TsanaPhysics/iSoil-pH-xAI/hardware/pinout_diagram.md

# แผนผังการต่อสายและข้อมูลขาเชื่อมต่อ (Hardware Pinout Diagram)

## 1. ผังการต่อสายระหว่างโมดูล pH-4502C กับบอร์ด INEX NX-WIO Terminal

```
+---------------------------------------+         +-----------------------------------------+
|     โมดูลวัดค่า pH (pH-4502C)         |         |      บอร์ดทดลอง INEX NX-WIO Terminal    |
|                                       |         |                                         |
|  [ V+ / VCC ] (ไฟเลี้ยงโมดูล 5.0V)   | ------> |  [ +Vs (max 5V) ] (พินจ่ายไฟเลี้ยง 5V)   |
|  [ G  / GND ] (กราวด์ร่วม)            | ------> |  [ GND ]          (พินกราวด์ร่วม)        |
|  [ Po / A-Out ] (สัญญาณอนาล็อก pH)     | ------> |  [ ช่องสกรีน 27 ] (ขา A0 ของ Wio)       |
|  [ Do / D-Out ] (สัญญาณดิจิทัลตัดเกณฑ์)| ------> |  (ไม่ต้องต่อใช้งาน)                     |
|  [ To / Temp  ] (สัญญาณอุณหภูมิบอร์ด)  | ------> |  (ไม่ต้องต่อใช้งาน)                     |
|                                       |         |                                         |
|  [ ขั้วต่อ BNC ]                      | ======> |  เสียบเข้ากับสายโพรบแก้ววัด pH          |
+---------------------------------------+         +-----------------------------------------+
```

---

## 2. แผนผังขา 40-Pin Header ของ Wio Terminal (เข้ากันได้กับ Raspberry Pi)

```
                  [ ด้านหลัง Wio Terminal ]
                    ---------------------
       +3.3V Power  [ 1]  [ 2]  +5.0V Power  <--- [ต่อไฟเลี้ยง V+ ของ pH-4502C ที่นี่]
     BCM 2 (SDA/I2C) [ 3]  [ 4]  +5.0V Power
     BCM 3 (SCL/I2C) [ 5]  [ 6]  GND         <--- [ต่อกราวด์ G ของ pH-4502C ที่นี่]
             BCM 4  [ 7]  [ 8]  BCM 14 (TXD)
               GND  [ 9]  [10]  BCM 15 (RXD)
            BCM 17  [11]  [12]  BCM 18 (PWM)
[A0] <---   BCM 27  [13]  [14]  GND
(ต่อ Po)    BCM 22  [15]  [16]  BCM 23
             +3.3V  [17]  [18]  BCM 24
     BCM 10 (MOSI)  [19]  [20]  GND
      BCM 9 (MISO)  [21]  [22]  BCM 25
     BCM 11 (SCLK)  [23]  [24]  BCM 8 (CE0)
               GND  [25]  [26]  BCM 7 (CE1)
            ID_SD   [27]  [28]  ID_SC
             BCM 5  [29]  [30]  GND
             BCM 6  [31]  [32]  BCM 12 (PWM)
            BCM 13  [33]  [34]  GND
    BCM 19 (MISO2)  [35]  [36]  BCM 16
            BCM 26  [37]  [38]  BCM 20 (MOSI2)
               GND  [39]  [40]  BCM 21 (SCLK2)
                    ---------------------
```

---

## 3. ข้อควรระวังระดับแรงดันไฟฟ้า (Voltage Matching)
* **ไฟเลี้ยงโมดูล:** 5.0V DC จากพอร์ต USB ของบอร์ด
* **อินพุต ADC ของ MCU:** ชิป ATSAMD51 ทนแรงดันไม่เกิน **3.30V**
* **การปรับจูนความปลอดภัย:** ปรับทริมพอตตัวล่าง (Offset Trimmer) ของโมดูล pH-4502C ให้แรงดันขา `Po` อยู่ที่ **1.650V** เมื่อจำลอง pH 7.00
