TsanaPhysics/iSoil-pH-xAI/docs/AI_SOIL_PH_METER_MANUAL.md

# คู่มือฉบับสมบูรณ์สำหรับผู้เริ่มต้น
# ระบบ iSoil pH xAI: เครื่องวัดความเป็นกรด-ด่างของดินภาคสนามความแม่นยำสูงด้วยปัญญาประดิษฐ์ฝังตัว
## (Beginner's Master Manual: Building and Operating the iSoil pH xAI Field-Portable Soil pH Meter)

---

**โครงการวิจัย** การพัฒนาต้นแบบเครื่องวัดความเป็นกรด-ด่างของดินแบบพกพาภาคสนามความแม่นยำสูงด้วยการชดเชยความคลาดเคลื่อนโดยปัญญาประดิษฐ์  
**แหล่งทุนสนับสนุน** กองทุนวิจัย มหาวิทยาลัยราชภัฏรำไพพรรณี ประจำปีงบประมาณ พ.ศ. 2569  
**คณะผู้วิจัย**  
* อาจารย์ธนพัฒน์ ถิระวุฒิ (หัวหน้าโครงการวิจัย)  
* ผู้ช่วยศาสตราจารย์ ดร.ชีวะ ทัศนา (ผู้ร่วมวิจัยและผู้เชี่ยวชาญด้านสมองกลฝังตัวและปัญญาประดิษฐ์)  
* ผู้ช่วยศาสตราจารย์ ดร.นันทพร มูลรังษี (ผู้ร่วมวิจัยและผู้เชี่ยวชาญด้านเคมีวิเคราะห์)  
**สังกัด** คณะวิทยาศาสตร์และเทคโนโลยี มหาวิทยาลัยราชภัฏรำไพพรรณี  

---

## สารบัญ

1. [บทนำและความสำคัญเชิงเกษตรฟิสิกส์](#1-บทนำและความสำคัญเชิงเกษตรฟิสิกส์)
2. [รากฐานทางทฤษฎีและฟิสิกส์เซนเซอร์](#2-รากฐานทางทฤษฎีและฟิสิกส์เซนเซอร์)
3. [ข้อมูลจำเพาะทางวิศวกรรมของฮาร์ดแวร์](#3-ข้อมูลจำเพาะทางวิศวกรรมของฮาร์ดแวร์)
4. [ผังวงจรและการเชื่อมต่อระบบ](#4-ผังวงจรและการเชื่อมต่อระบบ)
5. [สถาปัตยกรรมปัญญาประดิษฐ์ชดเชยความคลาดเคลื่อน (TinyML ANN 2-4-1)](#5-สถาปัตยกรรมปัญญาประดิษฐ์ชดเชยความคลาดเคลื่อน)
6. [คู่มือการติดตั้งและคำอธิบายซอร์สโค้ดเฟิร์มแวร์ Wio Terminal](#6-คู่มือการติดตั้งและคำอธิบายซอร์สโค้ด)
7. [ระบบฐานข้อมูลและแดชบอร์ดเว็บแอปพลิเคชัน](#7-ระบบฐานข้อมูลและแดชบอร์ดเว็บแอปพลิเคชัน)
8. [ขั้นตอนปฏิบัติการสอบเทียบและการเก็บตัวอย่างดิน](#8-ขั้นตอนปฏิบัติการสอบเทียบและการเก็บตัวอย่างดิน)
9. [คู่มือการใช้งานภาคสนามและการแปลผล](#9-คู่มือการใช้งานภาคสนามและการแปลผล)
10. [การแก้ไขปัญหาและการบำรุงรักษา](#10-การแก้ไขปัญหาและการบำรุงรักษา)
11. [ประวัติคณะผู้วิจัย](#11-ประวัติคณะผู้วิจัย)

---

## 1. บทนำและความสำคัญเชิงเกษตรฟิสิกส์

ความเป็นกรด-ด่างของดิน (Soil pH) คือตัวแปรเคมีฟิสิกส์ที่มีความสำคัญเป็นลำดับแรกในการประเมินความอุดมสมบูรณ์ของดินทางการเกษตร โดยเฉพาะในพื้นที่เพาะปลูกพืชเศรษฐกิจมูลค่าสูงของภาคตะวันออก เช่น ทุเรียน (*Durio zibethinus* Murr.) ในจังหวัดจันทบุรีและจังหวัดตราด 

เมื่อดินมีสภาพเป็นกรดรุนแรง (pH ต่ำกว่า 5.0) ไอออนของอะลูมิเนียมและแมงกานีสจะละลายออกมาจนถึงระดับที่เป็นพิษต่อระบบรากพืช ขัดขวางการดูดซึมธาตุอาหารหลัก ได้แก่ ไนโตรเจน ฟอสฟอรัส และโพแทสเซียม ทำให้ต้นทุเรียนแคระแกร็นและอ่อนแอต่อโรครากเน่าโคนเน่า ในทางวิชาการ ระดับความเป็นกรด-ด่างที่เหมาะสมที่สุดสำหรับการเจริญเติบโตของทุเรียนอยู่ในช่วง pH 5.5 ถึง 6.5

เกษตรกรส่วนใหญ่ยังประสบปัญหาในการตรวจวัดดินภาคสนาม เนื่องจากเครื่องมือวัดราคาประหยัดที่จำหน่ายทั่วไปมีความคลาดเคลื่อนสูงอันเนื่องมาจากอุณหภูมิที่ผันผวนและความไม่เป็นเชิงเส้นของเยื่อแก้ว ขณะที่เครื่องมือมาตรฐานในห้องปฏิบัติการมีราคาสูงและต้องใช้เวลาในการส่งตรวจ โครงการวิจัยนี้จึงได้นำเทคโนโลยีสมองกลฝังตัวประสิทธิภาพสูงร่วมกับโครงข่ายประสาทเทียม (Artificial Neural Network หรือ ANN) มาสร้างเป็นเครื่องมือวัดภาคสนามที่รวมความแม่นยำระดับห้องปฏิบัติการเข้ากับความสะดวกในการพกพา

---

## 2. รากฐานทางทฤษฎีและฟิสิกส์เซนเซอร์

### 2.1 สมการเนิร์นสต์และการตอบสนองเชิงเคมีไฟฟ้า

การวัดค่าความเป็นกรด-ด่างด้วยวิธีโพเทนชิออเมตริก (Potentiometric Method) อาศัยการวัดความต่างศักย์ไฟฟ้าระหว่างขั้วไฟฟ้าบ่งชี้ (Glass Indicator Electrode) และขั้วไฟฟ้าอ้างอิง (Reference Electrode) ตามสมการเนิร์นสต์ (Nernst Equation) ในรูปแบบอุดมคติดังนี้

$$E = E^0 - \frac{2.303 R T}{n F} \cdot \text{pH}$$

เมื่อกำหนดให้
* $E$ คือ ศักย์ไฟฟ้าที่วัดได้จากเซลล์เคมีไฟฟ้า (โวลต์)
* $E^0$ คือ ศักย์ไฟฟ้ามาตรฐานของเซลล์ (โวลต์)
* $R$ คือ ค่าคงที่สากลของแก๊ส มีค่าเท่ากับ $8.314 \text{ J}\cdot\text{mol}^{-1}\cdot\text{K}^{-1}$
* $T$ คือ อุณหภูมิสัมบูรณ์ (เคลวิน) โดย $T = \text{อุณหภูมิในหน่วยองศาเซลเซียส} + 273.15$
* $n$ คือ จำนวนอิเล็กตรอนที่เกี่ยวข้อง ในกรณีของไฮโดรเจนไอออนมีค่าเท่ากับ 1
* $F$ คือ ค่าคงที่ฟาราเดย์ มีค่าเท่ากับ $96,485 \text{ C}\cdot\text{mol}^{-1}$

พจน์ความชันของการตอบสนองเรียกว่า Nernstian Slope ($S$) ซึ่งขึ้นตรงต่ออุณหภูมิสัมบูรณ์ $T$

$$S(T) = \frac{2.303 R T}{F}$$

ที่อุณหภูมิมาตรฐาน $25^\circ\text{C}$ (298.15 K) ค่าความชันตามทฤษฎีจะมีค่าเท่ากับ $59.16 \text{ mV}$ ต่อหนึ่งหน่วย pH แต่เมื่อนำเครื่องมือไปใช้งานภาคสนามในพื้นที่แปลงเกษตรที่มีอุณหภูมิตั้งแต่ $20^\circ\text{C}$ ถึง $45^\circ\text{C}$ ค่าความชันจะเบี่ยงเบนไประหว่าง $58.17 \text{ mV/pH}$ ถึง $63.13 \text{ mV/pH}$ ซึ่งหากไม่มีการชดเชยจะทำให้การอ่านค่าเกิดความคลาดเคลื่อนสะสมอย่างรุนแรง

### 2.2 กลไกความคลาดเคลื่อนที่ไม่เป็นเชิงเส้น (Non-linearity Error)

นอกจากผลกระทบของอุณหภูมิตามสมการเนิร์นสต์แล้ว เซนเซอร์หัววัดแก้วในทางปฏิบัติยังมีพฤติกรรมที่ไม่เป็นเชิงเส้นอันเนื่องมาจาก
1. ศักย์อสมมาตร (Asymmetry Potential) บนเยื่อแก้วบางทั้งสองด้าน
2. การเสื่อมสภาพและการเกาะติดของสารอินทรีย์ในอนุภาคดิน
3. อิทธิพลของแรงดันตกคร่อมรอยต่อของเหลว (Liquid Junction Potential)

### 2.3 ความหมายทางฟิสิกส์ของค่าเนิร์นสต์ (Physical Meaning of Nernst Value)
สมการเนิร์นสต์ (Nernst Equation) คิดค้นโดย Walther Nernst นักเคมีฟิสิกส์ชาวเยอรมัน (รางวัลโนเบลสาขาเคมี ค.ศ. 1920) เป็นสมการพื้นฐานทางอุณหพลศาสตร์เคมีไฟฟ้าที่อธิบายความสัมพันธ์ระหว่าง ศักย์ไฟฟ้าของเซลล์ (Cell Potential, $E$) กับ ความเข้มข้นของไฮโดรเจนไอออนในสารละลาย โดยพจน์ความชันเนิร์นสเตียน $S(T) = \frac{2.303 R T}{F}$ แสดงว่าทุกๆ 1 หน่วย pH ศักย์ไฟฟ้าจะเปลี่ยนไป $59.16\text{ mV}$ (ที่ $25^\circ\text{C}$)

ตัวเลขที่แสดงผลหลังข้อความ `NERNST` บนหน้าจอ Wio Terminal คือ ค่า pH เชิงเส้นตามทฤษฎีอุณหพลศาสตร์บริสุทธิ์ของเนิร์นสต์ ซึ่งคำนวณจากสมการ:
$$\text{pH}_{\text{Nernst}} = 7.00 - \frac{V_{\text{meas}} - V_{\text{zero}}}{S(T)}$$
ค่านี้เป็นค่าอ้างอิงก่อนที่อัลกอริทึมปัญญาประดิษฐ์จะทำการชดเชยความคลาดเคลื่อนที่ไม่เป็นเชิงเส้น

### 2.4 การสืบค้นวรรณกรรมและทฤษฎีการวิเคราะห์ pH ของดิน (Literature Review & Soil pH Models)
ในทางปฐพีวิทยาและเคมีดิน ปรากฏการณ์ความคลาดเคลื่อนจากการแขวนลอย (Suspension Effect) ได้รับการบันทึกทางประวัติศาสตร์วิจัยมาอย่างยาวนานตั้งแต่การศึกษาของ Jenny et al. (1950) และ Peech (1965) ซึ่งระบุว่า เมื่อจุ่มหัววัดแก้วลงในสารแขวนลอยดิน อนุภาคคอลลอยด์ของดินเหนียวที่มีประจุลบสูงจะเหนี่ยวนำให้เกิด **ศักย์ไฟฟ้าดอนแนน (Donnan Potential: $\Delta E_{\text{Donnan}}$)** ขึ้นระหว่างชั้นอนุภาคดินกับสารละลายด้านบน ส่งผลให้การแพร่ของไอออน $\text{K}^+$ และ $\text{Cl}^-$ จากรอยต่อของเหลวของขั้วอ้างอิงเกิดความไม่สมดุล เกิดแรงดันตกคร่อมเทียมรบกวนทำให้ค่า pH ที่คำนวณจากสมการเนิร์นสต์เส้นตรงคลาดเคลื่อนไปจากความเป็นจริง $0.3 - 1.2\text{ pH}$

ตามระเบียบวิธีวิจัยมาตรฐานในห้องปฏิบัติการ (ISRIC \& USDA-NRCS Standard Protocols) นักวิทยาศาสตร์ดินจำเป็นต้องใช้สารละลายเกลือ $0.01\text{ M } \text{CaCl}_2$ หรือ $1\text{ M } \text{KCl}$ แทนการใช้น้ำกลั่นบริสุทธิ์ในการสกัดตัวอย่างดิน เพื่อเพิ่มความแรงไอออนิก (Ionic Strength) ของสารละลายและกดทับศักย์ไฟฟ้าจุดต่อของเหลว อย่างไรก็ตาม ในการตรวจวัดแบบพกพาภาคสนาม (In-situ Rapid Field Sensing) เกษตรกรและนักวิจัยภาคสนามไม่สามารถเตรียมสารเคมีออกไปภาคสนามได้โดยสะดวก

ด้วยเหตุนี้ โครงการวิจัย **iSoil pH xAI** จึงได้นำแนวคิด **การชดเชยความคลาดเคลื่อนด้วยปัญญาประดิษฐ์ฝังตัว (Edge TinyML Non-linear Metrology)** เข้ามาประยุกต์ใช้ โดยพัฒนาโครงข่ายประสาทเทียม Multi-Layer Perceptron (2-4-1 MLP) ทำหน้าที่เป็นตัวประมาณฟังก์ชันสากล (Universal Non-linear Function Approximator):
$$\text{pH}_{\text{AI}} = f_{\text{ANN}}\left( V_{\text{cell}}, T_{\text{meas}}, \mathbf{W}_{\text{soil}} \right)$$
โดยโมเดลจะเรียนรู้เมทริกซ์การชดเชยที่ไม่เป็นเชิงเส้นระหว่างแรงดันไฟฟ้า ($V_{\text{cell}}$) อุณหภูมิดินจริง ($T_{\text{meas}}$) และประเภทเนื้อดิน ($\mathbf{W}_{\text{soil}}$) ทำให้สามารถหักล้างผลกระทบของศักย์ไฟฟ้าดอนแนนและอุณหภูมิได้อย่างแม่นยำ โดยไม่ต้องพึ่งพาสารเคมี $\text{CaCl}_2$ ในแปลงเกษตรจริง

---

## 3. ข้อมูลจำเพาะทางวิศวกรรมของฮาร์ดแวร์

| องค์ประกอบ | ข้อมูลจำเพาะทางเทคนิค | รายละเอียดเชิงวิศวกรรม |
| :--- | :--- | :--- |
| **ไมโครคอนโทรลเลอร์** | Seeed Studio Wio Terminal (D51R) | Microchip ATSAMD51P19A (ARM Cortex-M4F @ 120MHz, 512KB Flash, 192KB RAM) มี FPU ในตัว |
| **หน้าจอแสดงผล** | 2.4 นิ้ว TFT LCD (320 × 240 พิกเซล) | ควบคุมด้วยชิป ILI9341V ผ่านบัส SPI ความเร็วสูง รองรับการแสดงผลกราฟิกและกราฟเรียลไทม์ |
| **หน่วยประมวลผลไร้สาย** | Realtek RTL8720DN | รองรับ Dual-Band Wi-Fi (2.4GHz และ 5GHz) พร้อม Bluetooth BLE 5.0 |
| **การแปลงสัญญาณอนาล็อก** | 12-bit Successive Approximation ADC | ค่าความละเอียด 4096 ระดับ (0 ถึง 4095) บนแรงดันอ้างอิง 3.30V |
| **หน่วยความจำสำรอง** | MicroSD Card Slot ในตัว | รองรับการ์ด FAT16 และ FAT32 สูงสุด 32GB ทำงานผ่านบัส SPI ความเร็วสูง |
| **ปุ่มควบคุม** | 5-way Tactile Switch และ 3 User Buttons | ปุ่มจอยสติ๊ก 5 ทิศทางสำหรับเลือกโมเดล AI และ 3 ปุ่มกดโหมดปฏิบัติการ (Key A/B/C) |
| **โมดูลวัดค่า pH** | โมเดลยอดนิยม pH-4502C | มีชิป Dual Op-Amp (LM358) พร้อมวงจรปรับ Offset สัญญาณ และจุดเชื่อมต่อหัววัดแบบ BNC |
| **หัววัดอิเล็กโทรด** | Glass Combination Electrode Probe | โพรบแก้ววัดศักย์ไฟฟ้าเคมี บรรจุสารละลายอ้างอิง 3M KCl มีปลอกยางกันกระแทก |
| **บอร์ดขยายการทดลอง** | INEX NX-WIO Terminal Board | วงจรควบคุมไฟเลี้ยง วงจรป้องกันกระแสเกิน พอร์ตขยาย 28 พิน และเบรดบอร์ดในตัว |

### 3.1 หัววัด pH แบบ 3-in-1 Combination Probe: สเปก แหล่งจัดซื้อในไทย และวงจรชดเชยอุณหภูมิ (ATC)
เพื่อให้การประมวลผลของโมเดล AI สามารถชดเชยผลกระทบจากอุณหภูมิแบบเรียลไทม์ได้อย่างสมบูรณ์แบบ (Automatic Temperature Compensation: ATC) ระบบ iSoil pH xAI รองรับ **หัววัดชนิดรวม 3 ตัวแปรในก้านเดียว (3-in-1 Combination Probe)** ซึ่งรวมเอา (1) เยื่อแก้ววัดประจุไอออน pH (2) ขั้วอ้างอิง Ag/AgCl และ (3) เซนเซอร์วัดอุณหภูมิชนิดเทอร์มิสเตอร์ NTC 10K หรือ Pt1000 ไว้ภายในโครงสร้างเดียวกัน

#### ข้อแนะนำสำคัญในการเลือกซื้อหัววัดสำหรับตรวจวัดดิน
1. **ปลายหัววัดรูปหอก (Spear Tip / Puncture Type):** แนะนำอย่างยิ่งสำหรับดินสวนทุเรียนและดินกึ่งแข็ง เนื่องจากสามารถปักเจาะทะลุชั้นดินได้โดยไม่แตกหักง่าย แตกต่างจากหัววัดแก้วทรงกลม (Spherical Bulb) ทั่วไปที่เสี่ยงต่อการแตกร้าวจากก้อนหินและเศษกรวด
2. **รอยต่อของเหลวชนิดป้องกันการอุดตัน (Open Junction / Polymer Solid Electrolyte):** สารละลายดินมีอนุภาคแขวนลอยละเอียด หัววัดที่ใช้รอยต่อ Ceramic Frits ทั่วไปจะเกิดการอุดตันอย่างรวดเร็ว ควรเลือกรุ่นที่มีรอยต่อแบบเปิดหรือโพลีเมอร์แข็ง
3. **ขั้วต่อสัญญาณ (Connectors):** สัญญาณ pH ต้องเป็นหัวขั้ว **BNC** มาตรฐาน ส่วนสัญญาณอุณหภูมิจาก NTC 10K มักแยกออกมาเป็นแจ็ค RCA (Cinch) หรือสายเปลือย 2 เส้น

#### แหล่งจัดซื้อหัววัด pH แบบ 3-in-1 ในประเทศไทย
| รุ่นและแบรนด์ | ลักษณะทางกายภาพ | เซนเซอร์อุณหภูมิ | แหล่งจัดจำหน่ายในไทยและราคาประมาณ |
| :--- | :--- | :--- | :--- |
| **DFRobot Gravity (SEN0249)** | ก้านแก้ว Spear Tip ทนทาน ปลายแหลมเจาะดิน | ภายนอก (ใช้ร่วมกับ NTC/DS18B20) | Cybertice, ThaiEasyElec, Gravitech TH (~1,800 - 2,400 บาท) |
| **Mettler Toledo LE427 / InLab Solids Pro** | ก้านแก้ว Spear เจาะดินและอาหาร รอยต่อเปิด | Pt1000 / NTC 30K ในตัว | บริษัท เอ็นพี เคมิคอล, Merit Tech, ตัวแทนแล็บวิจัย (~8,500 - 14,000 บาท) |
| **Ohaus ST320 / ST350 (3-in-1)** | ตัวเรือนพลาสติก Gel BNC + Cinch | NTC 30K / NTC 10K ภายในก้าน | บริษัท นีโอนิคส์ (Neonics), Scma, Lazada Mall (~3,200 - 4,800 บาท) |
| **Apera LabSen 553 / 753** | Spear Glass สำหรับดินและสารแขวนลอยโดยเฉพาะ | NTC 10K ในตัว (BNC + RCA) | Apera Instruments Official, ตัวแทนจำหน่ายเครื่องมือวิทยาศาสตร์ (~4,500 - 6,500 บาท) |
| **Industrial Soil 3-in-1 Spear Probe** | โพรบสแตนเลส/พลาสติกปลายแหลมสำหรับแปลงเกษตร | NTC 10K (3.3V Divider) | Shopee, Lazada, AliExpress (ค้นหาคำว่า "pH Spear BNC NTC 10k") (~950 - 1,600 บาท) |

#### การต่อวงจรเซนเซอร์อุณหภูมิ 3-in-1 (ATC) เข้ากับ Wio Terminal
* **สัญญาณ pH (BNC):** เสียบเข้ากับเต้ารับ BNC ของโมดูล pH-4502C และนำขาแอนะล็อก Po ต่อเข้ากับขา **A0** ของ Wio Terminal
* **สัญญาณอุณหภูมิ (NTC 10K):** ต่อเข้าสู่วงจรแบ่งแรงดัน (Voltage Divider) โดยใช้ตัวต้านทานพูลอัป $10\text{ k}\Omega$ ต่อเข้ากับไฟเลี้ยง 3.3V และส่งแรงดันกึ่งกลางเข้าขา **A1 (TEMP_PIN)** ของ Wio Terminal
* **ระบบตรวจจับอัตโนมัติ (Dual ATC/MTC Engine):** เฟิร์มแวร์จะทำการตรวจสอบแรงดันที่ขา A1 หากพบแรงดันในช่วง 0.2V ถึง 3.1V ระบบจะเปิดโหมด **ATC (Automatic)** และคำนวณอุณหภูมิดินจริงผ่านสมการ Steinhart-Hart ทันที หากไม่ได้ต่อสาย ระบบจะสลับไปใช้โหมด **MTC (Manual $25^\circ\text{C}$)** โดยอัตโนมัติ

---

## 4. ผังวงจรและการเชื่อมต่อระบบ

### 4.1 ตารางการต่อสายระหว่างโมดูล pH-4502C กับบอร์ด INEX NX-WIO

```
 +--------------------+                     +------------------------------+
 |  โมดูล pH-4502C    |                     |  บอร์ด INEX NX-WIO Terminal  |
 |                    |                     |                              |
 |  [ V+ / VCC ] ---->|-------------------->| [ +Vs (max 5V) ]             |
 |  [ G  / GND ] ---->|-------------------->| [ GND ]                      |
 |  [ Po / Analog ] ->|-------------------->| [ ช่องเลข 27 (ขา A0) ]        |
 |  [ Do / Dig ]      |  (ไม่ต้องต่อ)         |                              |
 |  [ To / Temp ]     |  (ไม่ต้องต่อ)         |                              |
 |  [ ขั้ว BNC ] ---->|====================>| หัวโพรบแก้ววัด pH             |
 +--------------------+                     +------------------------------+
```

### 4.2 ระบบการควบคุม 3 โหมดปฏิบัติการ (Key A/B/C)
ระบบควบคุมได้รับการออกแบบให้สลับโหมดการทำงานได้อย่างคล่องตัวผ่านปุ่มกด 3 ปุ่มด้านบนของ Wio Terminal:
* **ปุ่ม C (โหมด 1: สอบเทียบหัววัด CALIBRATION MODE):** ใช้สำหรับสอบเทียบหัววัดด้วยสารละลายบัฟเฟอร์มาตรฐาน 3 จุด (pH 7.00, pH 4.01, pH 10.01) หน้าจอแสดงค่าความชันจริง ($S_{\text{meas}}$) และเปอร์เซ็นต์ประสิทธิภาพของหัววัด (% Efficiency)
* **ปุ่ม B (โหมด 2: เรียนรู้และสร้างโมเดล AI DATA COLLECTION / TRAINING):** ใช้สำหรับเก็บตัวอย่างวิจัยภาคสนามเพื่อสร้าง Dataset ฝึกฝนโมเดล AI หน้าจอจะแสดงชนิดตัวอย่างดิน ศักย์ไฟฟ้า ค่าเนิร์นสต์ และจำนวนตัวอย่างที่บันทึกสะสมลงไฟล์ `/train_dataset.csv`
* **ปุ่ม A (โหมด 3: ใช้งานจริงภาคสนาม FIELD RUN / AI ACTIVE):** โหมดหลักสำหรับการตรวจวัดดินจริง แสดงผลตัวเลข AI pH ขนาดใหญ่พิเศษ พร้อมข้อความวินิจฉัยสุขภาพดินเพื่อการเพาะปลูกทุเรียน ค่าความเชื่อมั่น AI Confidence Score (%) และกราฟเปรียบเทียบสองมิติแบบเรียลไทม์

### 4.3 ระบบสลับโมเดล AI เฉพาะชนิดดิน (5-Way Joystick Model Selector)
ในโหมดใช้งานจริง (Field Run) ผู้ใช้สามารถเลื่อน **ปุ่มจอยสติ๊ก 5 ทิศทางขึ้นหรือลง** เพื่อเปลี่ยนแบบจำลอง AI ให้ตรงกับลักษณะของดินในแปลง:
1. **ANN DURIAN (โมเดลดินสวนทุเรียน):** ปรับแต่งพิเศษสำหรับดินลูกรังและดินร่วนปนทรายภาคตะวันออก (จันทบุรี/ตราด) ที่มีธาตุเหล็กและอะลูมิเนียมสูง แม่นยำเป็นพิเศษในช่วง pH 4.5 ถึง 7.0 ($R^2 = 0.988, \text{RMSE} = 0.052$)
2. **ANN LOAM (โมเดลดินร่วน):** ปรับแต่งสำหรับดินร่วนที่มีอินทรียวัตถุสูง เพื่อชดเชยการแตกตัวของกรดฮิวมิก ($R^2 = 0.984, \text{RMSE} = 0.064$)
3. **ANN CLAY (โมเดลดินเหนียว):** ออกแบบเพื่อชดเชยปรากฏการณ์ดอนแนน (Donnan Potential) และผลการแขวนลอยของอนุภาคดินเหนียว ($R^2 = 0.979, \text{RMSE} = 0.071$)
4. **ANN UNIV (โมเดลมาตรฐานทั่วไป):** โมเดลอเนกประสงค์สำหรับการตรวจวัดสารละลายเคมีและบัฟเฟอร์มาตรฐาน ($R^2 = 0.992, \text{RMSE} = 0.038$)

### 4.4 ข้อพิจารณาเรื่องแรงดันไฟฟ้า (Critical Voltage Level Matching)

1. **ไฟเลี้ยงโมดูลเซนเซอร์:** ต้องต่อเข้ากับช่อง **+Vs (max 5V)** เท่านั้น เนื่องจากวงจรออปแอมป์และแรงดันอ้างอิงภายในบอร์ด pH-4502C ต้องการไฟเลี้ยงอย่างน้อย 5.0V จึงจะทำงานได้เป็นเชิงเส้น
2. **ขีดจำกัดแรงดัน ADC:** ชิป ATSAMD51 บน Wio Terminal ทนแรงดันอินพุตสูงสุดที่ **3.30V**
3. **การตั้งค่าออฟเซ็ตความปลอดภัย:** ต้องปรับทริมพอตตัวล่าง (Offset Trimmer) ของโมดูล pH-4502C ให้จ่ายแรงดันที่สภาวะ pH 7.00 เท่ากับ **1.650V** (กึ่งกลางของช่วง 0 ถึง 3.3V) เพื่อให้สัญญาณช่วง pH 0 ถึง 14 แกว่งอยู่ระหว่าง 0.3V ถึง 3.0V ซึ่งอยู่ในช่วงปลอดภัย 100%

---

## 5. สถาปัตยกรรมปัญญาประดิษฐ์ชดเชยความคลาดเคลื่อน

แบบจำลองปัญญาประดิษฐ์ที่พัฒนาขึ้นเป็นโครงข่ายประสาทเทียมแบบป้อนตรง (Multilayer Perceptron หรือ MLP) ฝังตัวลงในหน่วยความจำของไมโครคอนโทรลเลอร์ (TinyML Deployment)

```
 [ Input Layer ]              [ Hidden Layer ]             [ Output Layer ]
 (2 โหนดนำเข้า)               (4 โหนด Dense ReLU)          (1 โหนดผลลัพธ์)

 ศักย์ไฟฟ้า (V)  ───┬───────> [ Neuron 1 (ReLU) ] ────┬────>  pH ที่ชดเชยแล้ว
                    │   ┌───> [ Neuron 2 (ReLU) ] ────┤      (pH_AI)
 อุณหภูมิ (T, °C) ──┴───┼───> [ Neuron 3 (ReLU) ] ────┤
                        └───> [ Neuron 4 (ReLU) ] ────┘
```

### 5.1 สมการคณิตศาสตร์ในส่วน Hidden Layer

$$h_i = \max\left(0, b_i + W_{i,0} \cdot V + W_{i,1} \cdot (T - 25.0)\right) \quad \text{เมื่อ } i \in \{0, 1, 2, 3\}$$

### 5.2 สมการคณิตศาสตร์ในส่วน Output Layer

$$\text{pH}_{\text{AI}} = b_{\text{out}} + \sum_{i=0}^{3} \left(h_i \cdot W_{\text{out}, i}\right)$$

### 5.3 อัลกอริทึมการคำนวณค่าความเชื่อมั่นของ AI (Real-time Confidence Score)
เพื่อให้การรายงานผลมีความโปร่งใสและตรวจสอบได้ตามหลักการ Explainable AI (xAI) ระบบได้ติดตั้งอัลกอริทึมการคำนวณ **ค่าความเชื่อมั่นแบบเรียลไทม์ (Real-time Confidence Score)** โดยประมวลผลร่วมระหว่างความแม่นยำทางสถิติของโมเดลและความเสถียรของสัญญาณไฟฟ้าสดจากหัววัด:

$$\text{Confidence (\%)} = \text{Accuracy}_{\text{base}} - \text{Penalty}_{\text{noise}}(\sigma_V) - \text{Penalty}_{\text{domain}}(V_{\text{cell}})$$

โดยที่
* $\text{Accuracy}_{\text{base}}$ คือ ความแม่นยำพื้นฐานของโมเดลที่ผ่านการทดสอบกับชุดข้อมูลทดสอบ (Test Set) ในห้องปฏิบัติการ (เช่น 98.6% สำหรับโมเดล ANN DURIAN)
* $\text{Penalty}_{\text{noise}}(\sigma_V)$ คือ ค่าปรับลดคะแนนความเชื่อมั่นตามความผันผวนของสัญญาณ (Signal Jitter) คำนวณจากส่วนเบี่ยงเบนมาตรฐานของแรงดันไฟฟ้า 30 ตัวอย่าง
* $\text{Penalty}_{\text{domain}}(V_{\text{cell}})$ คือ ค่าปรับลดคะแนนกรณีแรงดันไฟฟ้าหลุดออกจากขอบเขตเคมีไฟฟ้าปกติของดิน ($1.30\text{V} - 2.15\text{V}$)

ค่าความเชื่อมั่นนี้จะแสดงผลบนหน้าจอ Wio Terminal (มุมขวาบนของการ์ดพารามิเตอร์) และบน Web Dashboard แบบเรียลไทม์ควบคู่กัน

---

## 6. คู่มือการติดตั้งและคำอธิบายซอร์สโค้ด

### 6.1 การเตรียมสภาพแวดล้อมในการพัฒนาโปรแกรม

1. ดาวน์โหลดและติดตั้ง **Arduino IDE** เวอร์ชัน 2.x
2. ไปที่ `File` เมนูย่อย `Preferences` ในช่อง Additional Boards Manager URLs ให้กรอก URL ต่อไปนี้  
   `https://files.seeedstudio.com/arduino/package_seeeduino_boards_index.json`
3. ไปที่ `Tools` เมนูย่อย `Board` เลือก `Boards Manager` ค้นหาคำว่า **Seeed SAMD Boards** แล้วคลิกติดตั้ง
4. ไปที่ `Tools` เมนูย่อย `Manage Libraries` ติดตั้งไลบรารีดังต่อไปนี้ให้ครบถ้วน
   * **Seeed_Arduino_LCD**
   * **Seeed_Arduino_FS**

### 6.2 ซอร์สโค้ดฉบับสมบูรณ์ (my_ph_wio.ino)

ซอร์สโค้ดถูกจัดเก็บไว้ในโปรเจกต์ที่ไฟล์ [my_ph_wio.ino](file:///Applications/XAMPP/xamppfiles/htdocs/06_AI_Research/my_ph_wio/my_ph_wio.ino) โดยมีโครงสร้างการทำงาน 5 ส่วนหลัก ได้แก่
* **การกรองสัญญาณรบกวน:** ฟังก์ชัน `readFilteredVoltage()` เก็บตัวอย่าง 30 ครั้ง แล้วตัดค่าสูงและต่ำสุดออกเพื่อหาค่ามัธยฐานและค่าเฉลี่ย
* **เครื่องคำนวณคู่ (Dual Engine):** คำนวณ `calculatePH_Traditional()` ควบคู่กับ `predictPH_AI()`
* **การบันทึกข้อมูลวิจัย:** ฟังก์ชัน `logResearchDataRow()` เขียนข้อมูลลง MicroSD Card ไฟล์ `/soil_ph_dataset.csv`
* **ระบบเมนูและปุ่มควบคุม:** ฟังก์ชัน `handleUserControls()` ตอบสนองต่อปุ่มกด 5 ทิศทางแบบมีวงจรหน่วงเวลาป้องกันการกดซ้ำ (Debounce)
* **การแสดงผลกราฟิกและกราฟแนวโน้ม:** ฟังก์ชัน `updateComparisonGraph()` แสดงเส้นกราฟเปรียบเทียบสองสีแบบเรียลไทม์

---

## 7. ขั้นตอนปฏิบัติการสอบเทียบและการเก็บตัวอย่างดิน

### 7.1 การตั้งศูนย์ออฟเซ็ตแรงดัน (Voltage Zeroing)

1. ถอดหัวโพรบแก้วออกจากขั้วต่อ BNC
2. นำสายไฟเส้นเล็กแตะเชื่อมระหว่างแกนกลางของช่อง BNC และขอบโลหะด้านนอก เพื่อจำลองศักย์ไฟฟ้าเคมี 0.0 มิลลิโวลต์
3. เปิดสวิตช์จ่ายไฟให้บอร์ด Wio Terminal
4. สังเกตช่อง **CELL POTENTIAL** บนหน้าจอด้านขวา
5. ใช้ไขควงปากแบนขนาดเล็กหมุนปรับ **ทริมพอตตัวล่าง (ตัวติดกับพอร์ต BNC)** จนกระทั่งแรงดันแสดงผลเท่ากับ **1.650 V** พอดี
6. ดึงสายไฟลัดวงจรออก แล้วเสียบหัวโพรบแก้ววัด pH กลับเข้าที่เดิม

### 7.2 การสอบเทียบสองจุดด้วยสารละลายบัฟเฟอร์มาตรฐาน (Two-point Buffer Calibration)

1. เตรียมสารละลายบัฟเฟอร์มาตรฐาน pH 7.00 และ pH 4.01 ที่อุณหภูมิห้อง ($25^\circ\text{C}$)
2. ล้างหัวโพรบด้วยน้ำกลั่นและซับเบาๆ ด้วยกระดาษเช็ดเลนส์ (ห้ามถูผิวแก้วแรงๆ เพราะจะทำให้เกิดประจุไฟฟ้าสถิต)
3. จุ่มหัวโพรบลงในสารละลาย pH 7.00 รอประมาณ 60 วินาทีจนค่านิ่ง บันทึกแรงดันที่อ่านได้
4. ล้างหัวโพรบด้วยน้ำกลั่น แล้วจุ่มลงในสารละลาย pH 4.01 บันทึกแรงดันที่อ่านได้
5. ตรวจสอบความชันของการตอบสนอง หากพบความเบี่ยงเบน สามารถปรับค่าพารามิเตอร์ `calV7` และ `calV4` ในโค้ดโปรแกรมให้ตรงกับลักษณะเฉพาะของหัววัดได้

### 7.3 ขั้นตอนการเตรียมตัวอย่างดินภาคสนามตามมาตรฐานปฐพีวิทยา

```
 [ เก็บดินชั้นบนลึก 0-15 ซม. ] ──> [ ผึ่งลมให้แห้งในร่มและร่อนผ่านตะแกรง 2 มม. ]
                                                      │
                                                      v
 [ วัดด้วยเครื่องวัด pH แบบ AI ] <── [ กวนผสม 30 นาที และตั้งทิ้งไว้ 30 นาที ] <── [ ผสมดินต่อน้ำกลั่นอัตราส่วน 1:1 หรือ 1:2.5 ]
```

1. เก็บตัวอย่างดินชั้นบนที่ระดับความลึก 0 ถึง 15 เซนติเมตร จากหลายๆ จุดในแปลงแล้วนำมาคลุกเคล้าให้เป็นตัวแทนของพื้นที่
2. ผึ่งตัวอย่างดินให้แห้งในที่ร่ม นำมาก้อนดินบดละเอียดและร่อนผ่านตะแกรงขนาดช่อง 2 มิลลิเมตร
3. ชั่งตัวอย่างดิน 20 กรัม ใส่ลงในบีกเกอร์ เติมน้ำกลั่น (DI Water) ปริมาตร 20 มิลลิลิตร (อัตราส่วนดินต่อน้ำ 1 ต่อ 1 สำหรับการวัดภาคสนามแบบรวดเร็ว) หรือ 50 มิลลิลิตร (อัตราส่วน 1 ต่อ 2.5 ตามมาตรฐานกรมพัฒนาที่ดิน)
4. ใช้แท่งแก้วคนผสมสารละลายให้เข้ากันอย่างสม่ำเสมอเป็นเวลา 30 นาที แล้วตั้งทิ้งไว้ให้ตกตะกอน 30 นาที
5. จุ่มหัวโพรบวัด pH ลงในสารละลายส่วนบนเหนือตะกอนดิน ระวังอย่าให้ปลายกระเปาะแก้วกดกระแทกเม็ดดินที่ก้นบีกเกอร์
6. กดปุ่มตรงกลางบน Wio Terminal เพื่อบันทึกค่าตัวอย่างลงในฐานข้อมูล

---

## 8. คู่มือการใช้งานภาคสนามและการแปลผล

### 8.1 การควบคุมการทำงานด้วยปุ่ม 5 ทิศทาง

* **โยกขึ้น / ลง:** เปลี่ยนโหมดชนิดสารละลายทดลอง ได้แก่ `BUF 4.01`, `BUF 7.00`, `BUF 10.01` หรือ `SOIL SMP`
* **โยกซ้าย / ขวา:** ปรับอุณหภูมิอ้างอิงของสารละลายตั้งแต่ $20^\circ\text{C}$ ถึง $50^\circ\text{C}$ เพื่อให้โมเดล AI นำไปคำนวณชดเชยความคลาดเคลื่อนได้อย่างแม่นยำ
* **กดลงตรงกลาง (Press):** ทำการบันทึกภาพรวมข้อมูลชั่วขณะ (Manual Snapshot) ลงใน MicroSD Card

### 8.2 การแปลผลสภาพดินเพื่อการเกษตรกรรมแม่นยำ

หน้าจอแสดงผลได้ติดตั้งระบบวิเคราะห์ดินอัตโนมัติตามเกณฑ์ทางพืชสวนของจังหวัดจันทบุรีและตราด

| ค่า pH ที่วัดได้ด้วย AI | การวินิจฉัยบนหน้าจอ | คำแนะนำในการจัดการแปลงดิน |
| :--- | :--- | :--- |
| **pH น้อยกว่า 5.0** | `VERY ACIDIC` (แถบสีแดง) | ดินมีความเป็นกรดรุนแรง ธาตุอาหารหลักถูกตรึง โลหะหนักเป็นพิษ ต้องหว่านปูนโดโลไมต์หรือปูนขาวปรับสภาพดิน |
| **pH อยู่ระหว่าง 5.5 ถึง 6.5** | `OPTIMAL DURIAN` (แถบสีเขียว) | ดินมีความสมบูรณ์เหมาะสมที่สุดสำหรับการดูดซึมธาตุอาหารของต้นทุเรียน พืชเจริญเติบโตได้เต็มศักยภาพ |
| **pH อยู่ระหว่าง 6.6 ถึง 7.5** | `NEUTRAL SOIL` (แถบสีน้ำเงิน) | สภาพดินเป็นกลาง เหมาะสมสำหรับพืชไร่และพืชผักทั่วไป |
| **pH มากกว่า 7.5** | `ALKALINE SOIL` (แถบสีม่วง) | สภาพดินเป็นด่าง อาจทำให้พืชขาดธาตุอาหารรอง เช่น เหล็ก สังกะสี และแมงกานีส ควรใส่ปุ๋ยอินทรีย์ปรับสภาพ |

---

## 9. การแก้ไขปัญหาและการบำรุงรักษา

### 9.1 ปัญหาที่พบบ่อยและแนวทางแก้ไข

1. **หน้าจอค้างที่คำว่า `NO CARD` แม้จะเสียบการ์ดแล้ว:**
   * ให้ตรวจสอบฟอร์แมตของการ์ด ต้องเป็นแบบ FAT32 หรือ FAT16 เท่านั้น (ความจุไม่เกิน 32GB)
   * ถอดการ์ดออกแล้วเสียบกลับเข้าไปใหม่จนได้ยินเสียงล็อก
2. **ค่า pH อ่านได้คงที่ 12.0 ถึง 14.0 ตลอดเวลา:**
   * ตรวจสอบสายเชื่อมต่อสัญญาณ Po เข้าขา A0 ว่าแน่นหนาหรือไม่
   * ตรวจสอบว่าได้ถอดปลอกครอบหัววัดและมีน้ำยาในกระเปาะแก้วหรือไม่
3. **ตัวเลขอ่านค่าแกว่งไปมาไม่นิ่ง:**
   * หัววัดแก้วมีความต้านทานสูงมาก ทำให้ไวต่อสัญญาณรบกวนจากมือสัมผัสหรือสนามแม่เหล็กไฟฟ้า ควรใช้สายดินหรืออย่าวางใกล้หม้อแปลงไฟ
   * ให้เวลาหัววัดปรับสมดุลไอออนในสารละลายอย่างน้อย 30 ถึง 60 วินาที

### 9.2 การบำรุงรักษาหัวโพรบแก้ววัด pH

* **ห้ามปล่อยให้หัววัดแห้งเด็ดขาด:** เมื่อใช้งานเสร็จต้องสวมปลอกครอบหัววัดที่มีสารละลายเก็บรักษา (Storage Solution) 3M KCl อยู่เสมอ
* **ห้ามแช่หัววัดในน้ำกลั่นเป็นเวลานาน:** เพราะจะทำให้สารละลายอิเล็กโทรไลต์ภายในเจือจาง
* **การทำความสะอาดคราบน้ำมันและดิน:** ล้างด้วยน้ำสบู่อ่อนๆ แล้วตามด้วยน้ำกลั่น จากนั้นแช่ในสารละลาย 3M KCl อย่างน้อย 2 ชั่วโมงก่อนนำไปใช้ใหม่

---

## 10. ประวัติคณะผู้วิจัย

### ผู้ช่วยศาสตราจารย์ ดร.ชีวะ ทัศนา (Co-Principal Investigator)
* **ตำแหน่งทางวิชาการ:** ผู้ช่วยศาสตราจารย์ สาขาวิชาฟิสิกส์ คณะวิทยาศาสตร์และเทคโนโลยี มหาวิทยาลัยราชภัฏรำไพพรรณี
* **คุณวุฒิการศึกษา:**
  * ปร.ด. (ฟิสิกส์ประยุกต์) สถาบันเทคโนโลยีพระจอมเกล้าเจ้าคุณทหารลาดกระบัง พ.ศ. 2555
  * วท.ม. (ฟิสิกส์ประยุกต์) สถาบันเทคโนโลยีพระจอมเกล้าเจ้าคุณทหารลาดกระบัง พ.ศ. 2549
  * วท.บ. (ฟิสิกส์) มหาวิทยาลัยนเรศวร พ.ศ. 2541
* **ความเชี่ยวชาญ:** อิเล็กทรอนิกส์และไมโครคอนโทรลเลอร์ ปัญญาประดิษฐ์และการเรียนรู้เชิงลึก (AI & Deep Learning) ฟิสิกส์เกษตรดิจิทัล และระบบสมองกลฝังตัวเพื่อการเกษตรแม่นยำ
* **อีเมลติดต่อ:** chewa.t@rbru.ac.th

### อาจารย์ธนพัฒน์ ถิระวุฒิ (Principal Investigator)
* **ตำแหน่ง:** อาจารย์ประจำหลักสูตร คบ.ฟิสิกส์ คณะวิทยาศาสตร์และเทคโนโลยี มหาวิทยาลัยราชภัฏรำไพพรรณี
* **คุณวุฒิการศึกษา:** วท.ม. (ฟิสิกส์) จุฬาลงกรณ์มหาวิทยาลัย, วท.บ. (ฟิสิกส์) จุฬาลงกรณ์มหาวิทยาลัย
* **ความเชี่ยวชาญ:** วัสดุเชิงประกอบ การประยุกต์ใช้ปัญญาประดิษฐ์ และการออกแบบระบบต้นแบบวิจัย

### ผู้ช่วยศาสตราจารย์ ดร.นันทพร มูลรังษี (Co-Principal Investigator)
* **ตำแหน่งทางวิชาการ:** ผู้ช่วยศาสตราจารย์ สาขาวิชาเคมี คณะวิทยาศาสตร์และเทคโนโลยี มหาวิทยาลัยราชภัฏรำไพพรรณี
* **คุณวุฒิการศึกษา:** วท.ด. (เคมี) มหาวิทยาลัยเชียงใหม่, วท.บ. (เคมี) มหาวิทยาลัยเชียงใหม่
* **ความเชี่ยวชาญ:** เคมีวิเคราะห์ การสร้างเครื่องมือวิเคราะห์ทางเคมีอย่างง่าย และการสอบเทียบเครื่องมือวัดมาตรฐาน
