TsanaPhysics/iSoil-pH-xAI/docs/manual.pdf

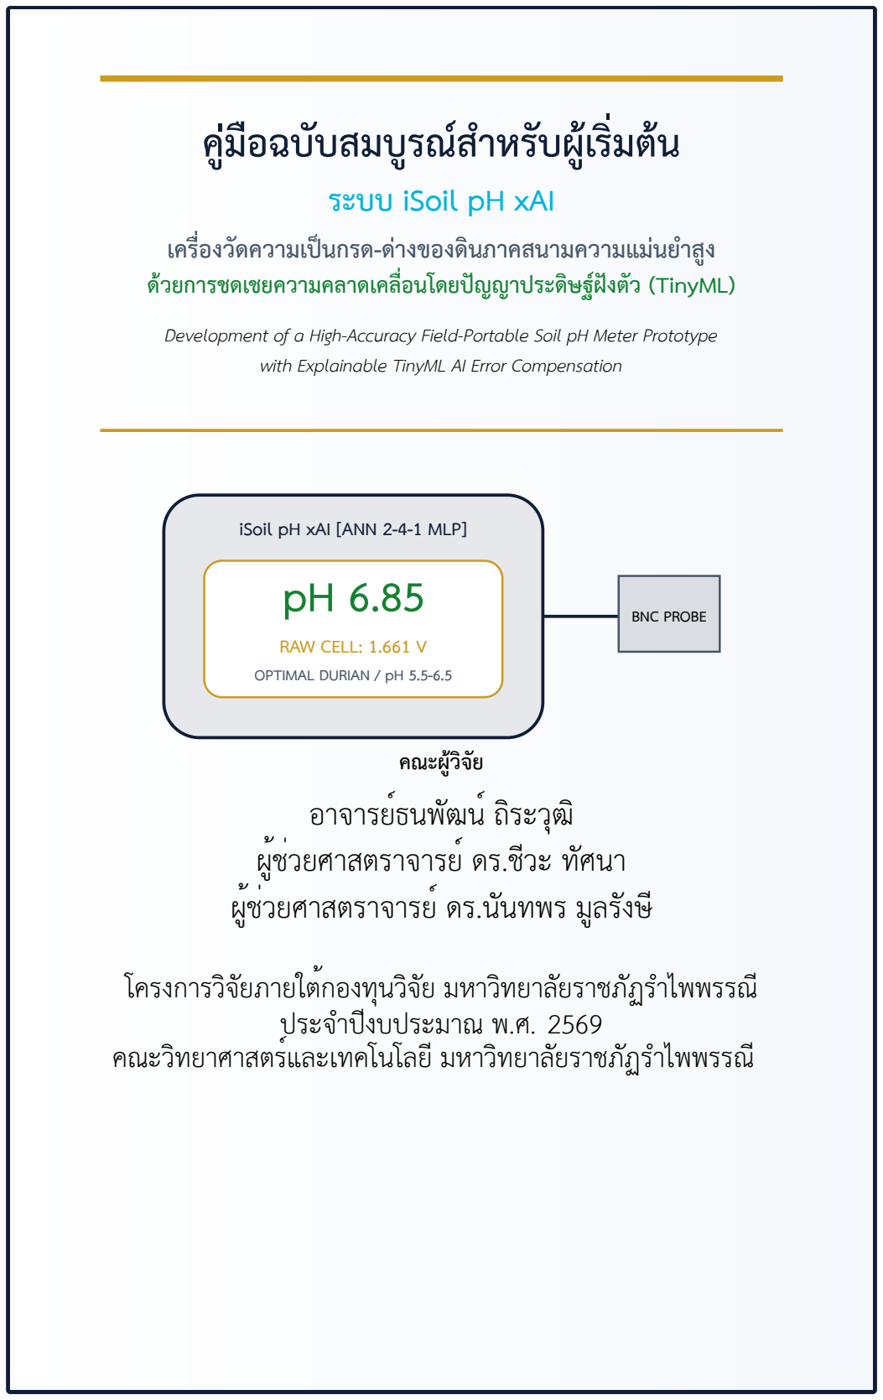
[picture p1: figure]
คู่มือฉบับสมบูรณ์สำหรับผู้เริ่มต้น ระบบ iSoil pH xAI; iSoil pH xAI [ANN 2-4-1 MLP] pH 6.85; RAW CELL: 1.661 V OPTIMAL DURIAN / pH 5.5-6.5; BNC PROBE; คณะผู้วิจัย; อาจารย์ธนพัฒน์ ถิระวุฒิ; ผู้ช่วยศาสตราจารย์ ดร.ชีวะ ทัศนา; ผู้ช่วยศาสตราจารย์ ดร.นันทพร มูลรังษี; โครงการวิจัยภายใต้กองทุนวิจัย มหาวิทยาลัยราชภัฏรำไพพรรณี; ประจำปีงบประมาณ พ.ศ. 2569 คณะวิทยาศาสตร์และเทคโนโลยี มหาวิทยาลัยราชภัฏรำไพพรรณี

## เครื่องวัดความเป็นกรด-ด่างของดินภาคสนามความแม่นยำสูง

## ด้วยการชดเชยความคลาดเคลื่อนโดยปัญญาประดิษฐ์ฝังตัว (TinyML)

Development of a High-Accuracy Field-Portable Soil pH Meter Prototype with Explainable TinyML AI Error Compensation

### คู่มือปฏิบัติการวิจัยและเทคโนโลยีปัญญาประดิษฐ์ฝังตัว

# บทที่ 1 บทนำและหลักการเกษตรฟิสิกส์

ความเป็นกรด-ด่างของดิน (Soil pH) เป็นดัชนีชี้วัดทางเคมีฟิสิกส์ที่กำหนดความสามารถ ในการละลายและการดูดซึมธาตุอาหารของพืช โดยเฉพาะอย่างยิ่งในพื้นที่เกษตรกรรม ของจังหวัดจันทบุรีและจังหวัดตราด ซึ่ง เป็นแหล่งผลิตพืช เศรษฐกิจสำคัญของประเทศ ได้แก่ ทุเรียน (Durio zibethinus Murr.) ดินส่วนใหญ่ในเขตนี้มักเผชิญภาวะดินกรดรุนแรง เนื่องจากมีปริมาณน้ำฝนสะสมสูงตลอดทั้งปี

สารละลายดิน

(Soil Slurry 1:1)

หัววัดแก้ว BNC

(Glass Electrode)

pH-4502C

(Offset 1.650V)

Wio Terminal

(TinyML ANN)

ไอออน H⁺ | mV ศักย์ | 0 - 3.3V

ภาพที่ 1.1 ผังการทำงานเชิงฟิสิกส์ของการแปลงความเข้มข้นไฮโดรเจนไอออนสู่การคำนวณด้วย ปัญญาประดิษฐ์

เมื่อดินมีค่า pH ต่ำกว่า 5.0 ไอออนของโลหะหนักโดยเฉพาะอะลูมิเนียม (Al³⁺) จะ ละลายออกมาเป็นพิษต่อระบบราก ขัดขวางการเจริญเติบโต และทำให้ผลผลิตตกต่ำ ใน ทางกลับกัน ค่า pH ที่เหมาะสมที่สุดสำหรับต้นทุเรียนจะอยู่ในช่วง 5.5 ถึง 6.5 ซึ่งเป็น ระดับที่ธาตุอาหารหลักและธาตุอาหารรองละลายออกมาได้อย่างสมดุล

### คู่มือปฏิบัติการวิจัยและเทคโนโลยีปัญญาประดิษฐ์ฝังตัว

# บทที่ 2 รากฐานทางทฤษฎีและสมการเนิร์นสต์

การตรวจวัดค่าความเป็นกรด-ด่างด้วยวิธีโพเทนชิออเมตริก (Potentiometric Method) อาศัยความต่างศักย์ไฟฟ้าระหว่างขั้วไฟฟ้าบ่งชี้เยื่อแก้ว (Glass Indicator Electrode) และขั้วไฟฟ้าอ้างอิง (Reference Electrode) ซึ่งอธิบายได้ด้วยสมการเนิร์นสต์ (Nernst Equation) ดังนี้

E = E

0 −

2.303RT
nF
- pH | (2.1)

เมื่อกำหนดให้

- E คือ ศักย์ไฟฟ้าที่อ่านได้จากเซลล์เคมีไฟฟ้า มีหน่วยเป็นโวลต์ (V)
- E

0 คือ ศักย์ไฟฟ้ามาตรฐานของเซลล์ มีหน่วยเป็นโวลต์ (V)

- R คือ ค่าคงที่สากลของแก๊ส (8.314 J · mol−1
- K

−1
)
- T คือ อุณหภูมิสัมบูรณ์ของสารละลาย มีหน่วยเป็นเคลวิน (K)
- n คือ จำนวนอิเล็กตรอนในปฏิกิริยา ซึ่งมีค่าเท่ากับ 1 สำหรับไฮโดรเจนไอออน
- F คือ ค่าคงที่ฟาราเดย์ (96, 485 C · mol−1
)

## 2.1 ความหมายทางฟิสิกส์ของค่าเนิร์นสต์ (Physical Meaning of Nernst Value)

สมการ เนิร์นสต์ (Nernst Equation) คิดค้น โดย Walther Nernst นัก เคมีฟิสิกส์ชาว เยอรมัน (รางวัลโนเบลสาขาเคมี ค.ศ. 1920) เป็นสมการพื้นฐานทางอุณหพลศาสตร์เคมี ไฟฟ้าที่อธิบายความสัมพันธ์ระหว่าง ศักย์ไฟฟ้าของเซลล์ (Cell Potential, E) กับ แอกทิวิตีหรือความเข้มข้น ของไอออนไฮโดรเจน (aH⁺ ) ในสารละลาย
กลุ่มพจน์ST =
2.303RT
F

เรียกว่า ความชันเนิร์นสเตียน (Nernstian Slope) ซึ่งมีความหมายทาง ฟิสิกส์ที่สำคัญยิ่งคือ “ทุกๆ การเปลี่ยนแปลงของระดับความเป็นกรด-ด่าง 1 หน่วย pH จะส่งผลให้ศักย์ไฟฟ้าที่เยื่อแก้วของหัว

ตารางที่ 2.1 ค่าความชันเนิร์นสเตียนตามทฤษฎีที่ระดับอุณหภูมิต่างๆ

อุณหภูมิ (◦
C) อุณหภูมิสัมบูรณ์ (K) ความชัน (S, mV/pH) ลักษณะการนำไปใช้งาน
20.0 | 293.15 | 58.17 | สภาวะห้องทดลองควบคุมอุณหภูมิ
25.0 | 298.15 | 59.16 | อุณหภูมิมาตรฐานสากลอ้างอิง
30.0 | 303.15 | 60.15 | สภาวะแปลงเกษตรภาคสนามช่วงเช้า
35.0 | 308.15 | 61.14 | สภาวะแปลงเกษตรภาคสนามกลาง แจ้ง
40.0 | 313.15 | 62.13 | สภาวะแดดจัดในดินภาคตะวันออก
45.0 | 318.15 | 63.13 | สภาวะทดสอบความทนทานขีดสุด

วัดเปลี่ยนแปลงไปเท่ากับค่าความชัน ST ” โดยที่อุณหภูมิห้องมาตรฐาน 25◦C (298.15 K) ค่าความชัน อุดมคติจะมีค่าเท่ากับ 59.16 mV/pH เสมอ หากหัววัดมีค่าความชันต่ำกว่า 50 mV/pH หรือมีประสิทธิภาพ (Electrode Efficiency) ต่ำกว่า 85% แสดงว่าเยื่อแก้วเสื่อมสภาพ หรือมีคราบสกปรกอุดตัน

## 2.2 ข้อจำกัดของสมการเนิร์นสต์ในการวัดดินภาคสนาม

แม้สมการ เนิร์นสต์จะแม่นยำอย่างยิ่งในสารละลายบัฟเฟอร์อุดมคติของห้องปฏิบัติการ แต่เมื่อนำมาใช้งานกับ สารละลายดินจริง (Soil Matrix) จะเผชิญข้อจำกัดทางฟิสิกส์อย่างรุนแรง ได้แก่

1. ปรากฏการณ์ดอนแนนและผลการแขวนลอย (Donnan Potential & Suspension Effect) อนุภาคดินเหนียว (Clay Colloid) มีประจุลบที่ผิวปริมาณมหาศาล ทำให้ไอออนในสารละลายกระจาย ตัวไม่สม่ำเสมอ ส่งผลให้ศักย์ไฟฟ้าบริเวณผิวสัมผัสเกิดความเบี่ยงเบนจากเส้นตรง ของเนิร์นสต์อย่างมีนัยสำคัญ
2. ศักย์ไฟฟ้าจุดต่อของเหลว (Liquid Junction Potential) สารละลายสกัดดินมีความเข้มข้นของไอออน ต่ำและมีสารอินทรีย์ปะปน ทำให้เกิดความต่างศักย์ตกคร่อมบริเวณรอยต่อของหัว วัดอ้างอิง ซึ่งสมการเนิร์นสต์ดั้งเดิมไม่ได้นำมาคิดคำนวณ
3. ผลกระทบจากอุณหภูมิแบบไม่เชิงเส้น (Non-linear Temperature Dependency) การเปลี่ยนแปลงอุณหภูมิ ภาคสนามไม่เพียงเปลี่ยนความชัน ST เท่านั้น แต่ยังส่งผลต่อค่าคงที่การแตกตัวของ กรดอินทรีย์ในดินและสารกึ่งตัวนำในวงจรแอนะล็อก

## 2.3 การสืบค้นวรรณกรรมและทฤษฎีการชดเชยความคลาดเคลื่อนทางเคมีไฟฟ้าของดิน (Literature Review on Soil pH Models)

ในทางปฐพีวิทยาและเคมีดิน ปรากฏการณ์ความคลาดเคลื่อนจากการแขวนลอย (Suspension Effect) ได้รับการบันทึกทางประวัติศาสตร์วิจัยมาอย่างยาวนานตั้งแต่การศึกษา ของ Jenny et al. (1950) และ Peech (1965) ซึ่งระบุว่า เมื่อจุ่มหัววัดแก้วลงในสาร แขวนลอยดิน อนุภาคคอลลอยด์ที่มีประจุลบสูงจะเหนี่ยวนำให้เกิด ศักย์ไฟฟ้าดอนแนน (Donnan Potential: ∆EDonnan) ขึ้นระหว่างชั้นอนุภาคคอลลอยด์กับของเหลวด้านบน ส่งผลให้การ

เคลื่อนที่ของไอออน K⁺
และ Cl−

จากรอยต่อของเหลวของขั้วอ้างอิง (Liquid Junction of Reference Electrode) เกิดความไม่สมดุล เกิดแรงดันตกคร่อมเทียมรบกวนทำให้ค่า pH ที่คำนวณจากสมการเนิร์นสต์เส้นตรงคลาดเคลื่อนไปจากความเป็นจริง 0.3 − 1.2 pH

ตามระเบียบวิธีวิจัยมาตรฐานดั้งเดิมในห้องปฏิบัติการ (ISRIC & USDA-NRCS Standard Protocols) นักวิทยาศาสตร์ดินจำเป็นต้องใช้สารละลายเกลือ 0.01 M CaCl2 หรือ 1 M KCl แทนการใช้น้ำกลั่นบริสุทธิ์ในการสกัดตัวอย่าง เพื่อเพิ่มความแรงไอออนิก (Ionic Strength) ของสารละลายและกดทับศักย์ไฟฟ้าจุดต่อของเหลว (Liquid Junction Potential Suppression) อย่างไรก็ตาม ในการตรวจวัดแบบพกพาภาคสนาม (In-situ Rapid Field Sensing) เกษตรกรและนักวิชาการส่ง เสริมการเกษตรไม่สามารถ เตรียมสาร เคมี และสารละลายอิเล็กโทรไลต์ออกไปภาคสนามได้โดยสะดวก
ด้วยเหตุนี้ คณะผู้วิจัยจึงได้นำแนวคิด การชดเชยความคลาดเคลื่อนด้วยปัญญาประดิษฐ์ฝังตัว (Edge TinyML Non-linear Metrology) เข้ามาประยุกต์ใช้ โดยพัฒนาโครงข่ายประสาทเทียมเพอร์เซป ตรอนหลายชั้น (Multilayer Perceptron: ANN) ขนาดกะทัดรัด (2-4-1 MLP) ทำหน้าที่ เป็นตัวประมาณฟังก์ชันสากล (Universal Non-linear Function Approximator) ดัง สมการ
pHAI = fANN (Vcell, Tmeas, Wsoil) | (2.2)
โดยโมเดลจะเรียนรู้เมทริกซ์การชดเชยที่ไม่เป็นเชิงเส้นระหว่างแรงดันไฟฟ้าจากเซลล์เคมี ไฟฟ้า (Vcell) อุณหภูมิดินจริง (Tmeas) และประเภทเนื้อดิน (Wsoil) ทำให้สามารถหักล้าง ผลกระทบของศักย์ไฟฟ้าดอนแนนและอุณหภูมิได้อย่างแม่นยำ โดยไม่ต้องพึ่งพาสารเคมี CaCl2 ในแปลงเกษตรจริง

### คู่มือปฏิบัติการวิจัยและเทคโนโลยีปัญญาประดิษฐ์ฝังตัว

# บทที่ 3 ฮาร์ดแวร์ ผังวงจร และการสร้างต้นแบบ

ต้นแบบเครื่องวัดค่าความเป็นกรด-ด่างของดินภาคสนามประกอบด้วย 3 ส่วนหลัก ได้แก่ บอร์ดไมโครคอนโทรลเลอร์ Seeed Studio Wio Terminal บอร์ดทดลอง INEX NX-WIO และชุดโมดูลวัดค่า pH-4502C พร้อมโพรบแก้ว

ตารางที่ 3.1 การต่อสายวงจรระหว่างเซนเซอร์ pH-4502C กับบอร์ด INEX NX-WIO

ขาของโมดูล pH-4502C | ตำแหน่งบนบอร์ด NX-WIO | หน้าที่และความสำคัญเชิงวิศวกรรม
V+ (VCC) | ขั้วไฟ +Vs (max 5V) | จ่ายไฟเลี้ยง 5.0V ให้วงจรขยาย
| | สัญญาณ Op-Amp
G (GND) | ขั้วกราวด์ GND | กราวด์ร่วมของระบบเพื่อความ
| | เสถียรของสัญญาณ
Po (Analog Out) | ช่อง เสียบ เลข [27] (ขา
| A0) | สัญญาณแรงดันแอนะล็อกเชื่อมต่อ
| | เข้าสู่ ADC 12 บิต
ขั้วต่อ BNC | เสียบเข้าหัวโพรบแก้ว | รับสัญญาณความต่างศักย์ระดับ
| | มิลลิโวลต์จากหัววัด

ข้อควรระวังสำคัญด้านความปลอดภัยของแรงดันไฟฟ้า

ชิปประมวลผล ATSAMD51 บนบอร์ด Wio Terminal ทำงานที่ระดับแรงดันลอ จิก 3.3 โวลต์ เท่านั้น ดัง นั้น ผู้ ปฏิบัติ การ ต้อง หมุน ปรับ ทริม พอ ต ตัว ล่าง (Offset Trimmer) ของโมดูล pH-4502C ให้จ่ายแรงดันที่สภาวะ pH 7.00 เท่ากับ 1.650 โวลต์เสมอ เพื่อป้องกันไม่ให้แรงดันเกิน 3.3 โวลต์เข้าสู่ขา ADC ของไมโคร คอนโทรลเลอร์

## 3.1 ระบบการควบคุม 3 โหมดและการใช้งานปุ่มบนตัวเครื่อง Wio Terminal

เพื่อความคล่องตัวในการปฏิบัติงานจริง ระบบได้ออกแบบให้ควบคุมผ่านปุ่มกดด้านบน 3 ปุ่ม (Key A, B, C) และปุ่มควบคุม 5 ทิศทาง (5-Way Joystick) ดังนี้

1. ปุ่ม C (โหมดสอบเทียบเซนเซอร์: MODE_CALIBRATE) ใช้สำหรับสอบเทียบหัววัดด้วยสารละลาย มาตรฐาน 3 จุด (pH 7.00, pH 4.01, pH 10.01) หน้าจอจะแสดงค่าความชัน เนิร์นสต์จริง (Smeas) และเปอร์เซ็นต์ประสิทธิภาพของหัววัด (% Efficiency) พร้อม คำแนะนำความสมบูรณ์ของโพรบ
2. ปุ่ม B (โหมดเรียนรู้สร้างโมเดล AI: MODE_AI_LEARN) ใช้สำหรับเก็บตัวอย่างวิจัยภาคสนามเพื่อ สร้าง Dataset ฝึกฝนโมเดล AI หน้าจอจะแสดงชนิดตัวอย่างดิน ศักย์ไฟฟ้า ค่า เนิร์นสต์ และจำนวนตัวอย่างที่บันทึกสะสมลงไฟล์/train_dataset.csv
3. ปุ่ม A (โหมดใช้ งาน จริงภาค สนาม: MODE_FIELD_RUN) โหมดหลักสำหรับการตรวจวัดดินจริง แสดงผลตัวเลข AI pH ขนาดใหญ่พิเศษ พร้อมข้อความวินิจฉัยสุขภาพดินเพื่อการ เพาะปลูกทุเรียนและกราฟเปรียบเทียบสองมิติแบบเรียลไทม์
4. ปุ่ม 5 ทิศทาง (5-Way Joystick)
- ขึ้น/ลง (UP/DOWN): ในโหมดใช้งานจริง ใช้สำหรับสลับเปลี่ยนโมเดล AI เฉพาะ ชนิดดินทันที (ANN DURIAN ↔ ANN LOAM ↔ ANN CLAY ↔ ANN UNIV)
- ซ้าย/ขวา (LEFT/RIGHT): ปรับตั้งค่าอุณหภูมิสารละลายหรือดิน (◦C)
- กดตรงกลาง (PRESS): ในโหมด Calibrate ใช้ล็อคค่าอ้างอิง, ในโหมด AI Learn ใช้ บันทึกตัวอย่างฝึกฝน, และในโหมด Field Run ใช้ถ่ายภาพสแนปช็อตบันทึก ข้อมูลทันที

## 3.2 หัววัด pH แบบ 3-in-1 Combination Probe: สเปก แหล่งจัดซื้อ และวงจรชดเชย อุณหภูมิ (ATC)

เพื่อให้การประมวลผลของโมเดล AI สามารถชดเชยผลกระทบจากอุณหภูมิแบบเรียลไทม์ ได้อย่างสมบูรณ์แบบ (Automatic Temperature Compensation: ATC) ระบบ iSoil pH xAI จึงได้รับการออกแบบเฟิร์มแวร์และฮาร์ดแวร์ให้รองรับ หัววัดชนิดรวม 3 ตัวแปรในก้าน เดียว (3-in-1 Combination Probe) ซึ่งรวมเอา (1) เยื่อแก้ววัดประจุไอออน pH (2) ขั้วอ้างอิง Ag/ AgCl และ (3) เซนเซอร์วัดอุณหภูมิชนิดเทอร์มิสเตอร์ NTC 10K หรือ Pt1000 ไว้ภายใน โครงสร้างเดียวกัน

### 3.2.1 ข้อแนะนำในการเลือกซื้อหัววัดสำหรับตรวจวัดดินโดยเฉพาะ

การเลือกหัววัดสำหรับวัดในดินจริงมีความแตกต่างจากหัววัดน้ำทั่วไป ดังนี้

- ปลายหัววัดรูปหอก (Spear Tip / Puncture Type) แนะนำอย่างยิ่งสำหรับดินสวนทุเรียนและดิน กึ่งแข็ง เนื่องจากสามารถปักเจาะทะลุชั้นดินได้โดยไม่แตกหักง่าย แตกต่างจากหัว วัดแก้วทรงกลม (Spherical Bulb) ทั่วไปที่เสี่ยงต่อการแตกร้าวจากก้อนหินและ เม็ดทราย
- รอยต่อของเหลวชนิดป้องกันการอุดตัน (Open Junction / Polymer Gel) สารละลายดินมีอนุภาคแขวนลอย ละเอียด หัววัดที่ใช้รอยต่อ Ceramic Frits ทั่วไปจะเกิดการอุดตันอย่างรวดเร็ว ควร เลือกรุ่นที่มีรอยต่อแบบเปิดหรือโพลีเมอร์แข็ง (Solid Polymer)
- ขั้วต่อสัญญาณ (Connectors) สัญญาณ pH ต้องเป็นหัวขั้ว BNC มาตรฐาน ส่วนสัญญาณ อุณหภูมิจาก NTC 10K มักแยกออกมาเป็นแจ็ค RCA (Cinch) หรือสายเปลือย 2 เส้น

### 3.2.2 ผังการต่อวงจรเซนเซอร์อุณหภูมิ 3-in-1 เข้ากับ Wio Terminal

การเชื่อมต่อสัญญาณจากหัววัด 3-in-1 เข้าสู่ระบบควบคุม มีขั้นตอนดังนี้

1. สายสัญญาณ pH (BNC): เสียบเข้ากับเต้ารับ BNC ของโมดูล pH-4502C และนำขาแอนะ ล็อก Po ต่อเข้ากับขา A0 ของ Wio Terminal
2. สายสัญญาณอุณหภูมิ (NTC 10K): ต่อเข้าสู่วงจรแบ่งแรงดัน (Voltage Divider) โดยใช้ตัว ต้านทานพูลอัป 10 kΩ ต่อเข้ากับไฟเลี้ยง 3.3V และส่งแรงดันกึ่งกลางเข้าขา A1 (TEMP_PIN) ของ Wio Terminal
3. ระบบตรวจจับอัตโนมัติ (Dual ATC/MTC Engine): เฟิร์มแวร์จะทำการตรวจสอบแรงดันที่ขา A1 หากพบแรงดันในช่วง 0.2V ถึง 3.1V ระบบจะเปิดโหมด ATC (Automatic) และคำนวณ อุณหภูมิดินจริงผ่านสมการ Steinhart-Hart ทันที หากไม่ได้ต่อสาย ระบบจะสลับ ไปใช้โหมด MTC (Manual 25◦
C) โดยอัตโนมัติ

ตารางที่ 3.2 รุ่น หัว วัด pH แบบ 3-in-1 ที่ แนะนำ สำหรับ การ วิจัย ดิน และ แหล่ง จัด ซื้อ ใน ประเทศไทย

รุ่นและแบรนด์ | ลักษณะทางกายภาพ | เซนเซอร์อุณหภูมิ | แหล่งจัดจำหน่ายใน ไทย
DFRobot | Gravity
(SEN0249) | ก้านแก้ว Spear Tip ทนทาน ปลายแหลม เจาะดิน | รองรับ ร่วม กับ โพ รบ อุณหภูมิ ภายนอก | Cybertice, ThaiEasy- Elec, Gravitech TH, Shopee
Mettler | Toledo
LE427 | / | InLab
Solids Pro | ก้านแก้ว Spear เจาะ อาหาร และ ดิน รอย ต่อเปิด | Pt1000 / NTC 30K | บริษัท เอ็นพี เคมิคอล, Merit Tech, ตัวแทนแล็บ
Ohaus | ST320 | /
ST350 (3-in-1) | ตัว เรือน พลาสติก Gel BNC + Cinch | NTC 30K / NTC 10K ภายในก้าน | บริษัท นีโอ นิคส์ (Neonics), Scma, Lazada Mall

Apera LabSen 553 /
753
Spear | Glass
| สำหรับ ดิน และ สาร แขวนลอยโดยเฉพาะ | NTC 10K ใน ตัว (BNC + RCA) | Apera Instruments Official, ตัวแทน จำหน่ายเครื่อง มือแพทย์
Industrial Soil 3-in-1 Spear Probe | โพ รบ ส แตน เลส/ พลาสติกปลายแหลม สำหรับแปลงเกษตร | NTC 10K (3.3V Divider) | Shopee, Lazada, AliExpress (ค้นหา: “pH Spear BNC NTC 10k”)

### คู่มือปฏิบัติการวิจัยและเทคโนโลยีปัญญาประดิษฐ์ฝังตัว

# บทที่ 4 สถาปัตยกรรมปัญญาประดิษฐ์ฝังตัว (TinyML ANN

2-4-1)

แบบจำลองปัญญาประดิษฐ์ในระบบ iSoil pH xAI เป็นโครงข่ายประสาทเทียมแบบ Multi-Layer Perceptron (MLP) โครงสร้าง 2-4-1 ที่ได้รับการแปลงรูปให้ทำงานบนชิป ARM

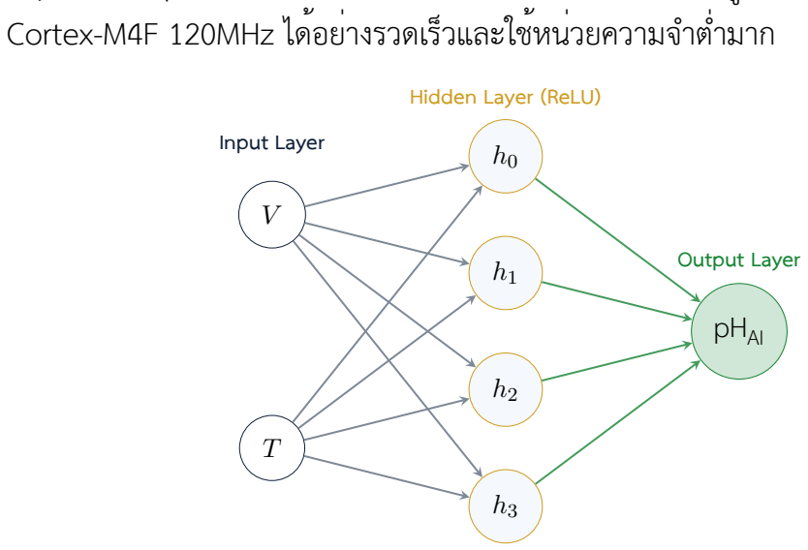
[picture p2: figure]
Cortex-M4F 120MHz ได้อย่างรวดเร็วและใช้หน่วยความจำต่ำมาก; pHAI; Input Layer; Hidden Layer (ReLU); Output Layer

ภาพที่ 4.1 สถาปัตยกรรมโครงข่ายประสาทเทียม ANN 2-4-1 ฝังตัวบน Wio Terminal

สมการคณิตศาสตร์ในชั้นซ่อนเร้นใช้ฟังก์ชันกระตุ้นแบบ ReLU max(0, z) เพื่อขจัด ความไม่เป็นเชิงเส้นและลดเวลาการคำนวณในระดับไมโครวินาที:

hi = max (0, bi + Wi,0 · V + Wi,1 · (T − 25.0)) (i = 0, 1, 2, 3) (4.1)

pHAI = bout +

∑
3

i=0

(hi

- Wout,i) | (4.2)

## 4.1 ระบบเลือกโมเดลปัญญาประดิษฐ์จำเพาะตามเนื้อดิน (Multi-Model AI Selector)

เนื่องจากคุณสมบัติทางเคมีไฟฟ้าของดินแต่ละชนิดมีความแตกต่างกันอย่างมีนัยสำคัญ ระบบ iSoil pH xAI จึงได้ติดตั้งชุดน้ำหนักของโมเดลโครงข่ายประสาทเทียมแบบฝังตัว 4 โมเดล เพื่อให้เกษตรกรและนักวิจัยสามารถเลือกใช้ให้ตรงกับชนิดของดินในแปลง

1. ANN DURIAN (โมเดลดินสวนทุเรียนตะวันออก) ได้รับการปรับแต่งจูนเป็นพิเศษสำหรับดินลูกรัง และดินร่วนปนทรายในเขตจังหวัดจันทบุรีและระยอง ซึ่งมักมีธาตุเหล็ก (F e) และ อะลูมิเนียม (Al) สูง โดยโมเดลนี้เน้นความละเอียดแม่นยำสูงพิเศษในช่วง pH 4.5 ถึง 7.0
2. ANN LOAM (โมเดลดินร่วน) ปรับแต่งสำหรับดินร่วนที่มีอินทรียวัตถุสูง (High Organic Matter) ซึ่งมีพฤติกรรมการแตกตัวของประจุที่สมดุล
3. ANN CLAY (โมเดลดินเหนียว) ออกแบบเพื่อชดเชยปรากฏการณ์ดอนแนน (Donnan Potential) และผลการแขวนลอยของอนุภาคดินเหนียว (Suspension Effect) ที่มี ประจุลบสูง
4. ANN UNIV (โมเดลมาตรฐานทั่วไป) โมเดลอเนกประสงค์สำหรับการตรวจวัดสารละลายเคมี และบัฟเฟอร์มาตรฐานทั่วไป

## 4.2 ดัชนีความเชื่อมั่นของโมเดล AI (Real-time Confidence Score) และการประเมินทาง สถิติ

เพื่อให้การรายงานผลมีความโปร่งใสและตรวจสอบได้ตามหลักการ Explainable AI (xAI) ระบบได้ติดตั้งอัลกอริทึมการคำนวณ ค่าความเชื่อมั่นแบบเรียลไทม์ (Real-time Confidence Score) โดย ประมวลผลร่วมระหว่างความแม่นยำทางสถิติของ โมเดลและความ เสถียรของสัญญาณ ไฟฟ้าสดจากหัววัด:

Confidence (%) = Accuracybase − Penaltynoise(σV ) − Penaltydomain(Vcell) (4.3)

โดยที่

- Accuracybase คือ ความแม่นยำพื้นฐานของโมเดลที่ผ่านการทดสอบกับชุดข้อมูล ทดสอบ (Test Set) ในห้องปฏิบัติการ
- Penaltynoise(σV ) คือ ค่าปรับลดคะแนนความเชื่อมั่นตามความผันผวนของสัญญาณ (Signal Jitter) คำนวณจากส่วนเบี่ยงเบนมาตรฐานของแรงดันไฟฟ้า 30 ตัวอย่าง

- Penaltydomain(Vcell) คือ ค่าปรับลดคะแนนกรณีแรงดันไฟฟ้าหลุดออกจากขอบเขต เคมีไฟฟ้าปกติของดิน (1.30V − 2.15V)

ตารางที่ 4.1 ผลการประเมินความแม่นยำทางสถิติและขอบเขตความเชื่อมั่นของโมเดลทั้ง 4 ชุด

โมเดล AI | สัมประสิทธิ์ (R²

) RMSE (pH) MAE (pH) ความแม่นยำพื้นฐาน (%)

ANN DURIAN | 0.988 | 0.052 | 0.041 | 98.6% (เน้น ดินกรด
pH 4.5–7.0)
ANN LOAM | 0.984 | 0.064 | 0.050 | 98.2% (ชดเชย กรด
| | | | ฮิวมิก)
ANN CLAY | 0.979 | 0.071 | 0.058 | 97.8% | (ชดเชย
Donnan Potential)
ANN UNIV | 0.992 | 0.038 | 0.029 | 99.0% | (บัฟเฟอร์
มาตรฐานอุดมคติ)

### คู่มือปฏิบัติการวิจัยและเทคโนโลยีปัญญาประดิษฐ์ฝังตัว

# บทที่ 5 ระบบฐานข้อมูลและแดชบอร์ดเว็บแอปพลิเคชัน

เพื่อสนับสนุนการทำเกษตรแม่นยำและการรายงานผลวิจัย ระบบได้เชื่อมโยง Wio Terminal เข้ากับแดชบอร์ดเว็บแอปพลิเคชันและฐานข้อมูลแบบเรียลไทม์:

1. สะพานส่งข้อมูล (Serial Bridge Daemon) ใช้สคริปต์ Python (tools/serial_bridge.py) อ่านข้อมูลจากพอร์ต USB Serial แล้วส่งต่อผ่าน HTTP POST ไปยังเซิร์ฟเวอร์
2. ฐานข้อมูล SQLite3 จัดเก็บประวัติการวัดค่าที่ไฟล์ data/soil_ph.db ซึ่งมีดัชนีเวลา เพื่อการค้นคืนข้อมูลที่รวดเร็ว
3. เว็บพอร์ทัลความเร็วสูง พัฒนาด้วย PHP และ JavaScript (Chart.js) แสดงผลกราฟเปรียบ เทียบสองมิติ บัตรดัชนีสุขภาพดิน และปุ่มส่งออกข้อมูลเป็น CSV ทันที

## 5.1 ระบบการจัดเก็บไฟล์ข้อมูลการทดลองแบบแยกเซสชันอัตโนมัติ

เพื่อสนับสนุนการทำวิจัยอย่างมีมาตรฐานและป้องกันการเขียนข้อมูลทับซ้อน ระบบได้ รับการออกแบบให้สร้างไฟล์ข้อมูลและเซสชันใหม่ทุกครั้งที่มีการรีเซตหรือเริ่มการทดลอง ใหม่

1. การสร้างไฟล์ใหม่บน MicroSD Card อัตโนมัติ (Sequential File Generation) เมื่อเปิดเครื่องใหม่หรือกด ปุ่มรีเซต ตัวประมวลผล Wio Terminal จะตรวจค้นไฟล์ใน MicroSD Card แล้ว สร้างไฟล์ลำดับใหม่โดยอัตโนมัติ (/exp_001.csv, /exp_002.csv, /exp_003.csv ...) พร้อมเขียนส่วนหัวคอลัมน์มาตรฐาน 10 คอลัมน์
2. การจัดหมวดหมู่ในฐานข้อมูลตามเซสชัน (Database Session Tracking) ข้อมูลที่ถูกส่งผ่าน Serial Bridge จะถูกกำกับด้วยรหัส session_id ตรงกับไฟล์ใน MicroSD Card ทำให้ผู้ใช้งาน สามารถเลือกดูประวัติ กราฟ และสถิติย้อนหลังแบบเจาะจงรายรอบการทดลองได้

3. การเริ่มรอบการทดลองใหม่ทันที (On-Demand Session Restart) ผู้ใช้งานสามารถสั่งเริ่มเซสชันใหม่ ได้ 3 ช่องทาง คือ (1) กดปุ่มบนซ้าย (ปุ่ม C) บนตัวเครื่อง Wio Terminal, (2) กด ปุ่ม “เริ่มใหม่ (New)” บนหน้าเว็บแดชบอร์ด, หรือ (3) ส่งคำสั่ง START_NEW ผ่าน พอร์ต Serial

### คู่มือปฏิบัติการวิจัยและเทคโนโลยีปัญญาประดิษฐ์ฝังตัว

# บทที่ 6 ขั้นตอนปฏิบัติการทดสอบและการใช้งานภาคสนาม

## 6.1 การเตรียมตัวอย่างดินตามระเบียบวิธีวิจัย

การเตรียมตัวอย่างดินเพื่อตรวจวัดภาคสนามให้ได้ผลแม่นยำสูงสุด มีขั้นตอนดำเนินการ ดังนี้

1. สุ่มเก็บตัวอย่างดินบนที่ระดับความลึก 0 ถึง 15 เซนติเมตร จากแปลงเกษตร 5 ถึง 10 จุด แล้วนำมารวมกันเป็นตัวแทนของแปลง
2. ผึ่งดินให้แห้งในที่ร่ม บดให้ละเอียดแล้วร่อนผ่านตะแกรงขนาดตา 2 มิลลิเมตร
3. ชั่งดิน 20 กรัม ผสมกับน้ำกลั่น 20 มิลลิลิตร (อัตราส่วน 1 ต่อ 1) หรือ 50 มิลลิลิตร (อัตราส่วน 1 ต่อ 2.5) ลงในขวดทดลอง
4. เขย่าหรือกวนสารละลายเป็นเวลา 30 นาที แล้วตั้งทิ้งไว้ให้ดินตกตะกอน 30 นาที
5. จุ่มหัวโพรบแก้วลงในสารละลายส่วนใส แล้วกดปุ่มบันทึกค่าลงใน MicroSD Card

## 6.2 เกณฑ์การวินิจฉัยสุขภาพดินเพื่อการเพาะปลูกทุเรียน

ระบบซอฟต์แวร์บนตัวเครื่องจะทำการประเมินค่าความเป็นกรด-ด่างและแสดงสถานะให้ เกษตรกรทราบทันทีบนหน้าจอ LCD ดังนี้

- pH น้อยกว่า 5.0 (VERY ACIDIC) ดินมีสภาพกรดรุนแรง ธาตุอาหารหลักถูกตรึง ต้องใส่ปูน โดโลไมต์ปรับสภาพ
- pH 5.5 ถึง 6.5 (OPTIMAL DURIAN) ดินมีความสมบูรณ์เหมาะสมที่สุดสำหรับการเจริญเติบโต ของทุเรียน
- pH 6.6 ถึง 7.5 (NEUTRAL SOIL) ดินมีสภาพเป็นกลาง เหมาะสำหรับพืชไร่และพืชสวนทั่วไป

- pH มากกว่า 7.5 (ALKALINE SOIL) ดินเป็นด่าง พืชอาจขาดธาตุสังกะสีและเหล็ก ควรใส่ปุ๋ย อินทรีย์

### คู่มือปฏิบัติการวิจัยและเทคโนโลยีปัญญาประดิษฐ์ฝังตัว

# บทที่ 6 เอกสารอ้างอิง (References)

1. Jenny, H., Nielsen, T. R., & Coleman, N. T. (1950). Junction potentials in dilute suspensions of sodium clay and sodium-ion activity measurements. Science, 112(2902), 164– 167.
2. Peech, M. (1965). Hydrogen-ion activity. In Methods of Soil Analysis: Part 2 Chemical and Microbiological Properties (Vol. 9, pp. 914–926). American Society of Agronomy, Soil Science Society of America.
3. Nernst, W. (1889). Die elektromotorische Wirksamkeit der Ionen. Zeitschrift für Physikalische Chemie, 4(1), 129–181.
4. Thomas, G. W. (1996). Soil pH and soil acidity. Methods of soil analysis: Part 3 Chemical methods, 5, 475–490.
5. Soil Survey Staff. (2014). Kellogg Soil Survey Laboratory Methods Manual. Soil Survey Investigations Report No. 42, Version 5.0. U.S. Department of Agriculture, Natural Resources Conservation Service.
6. Viscarra Rossel, R. A., & Behrens, T. (2010). Using data mining to model and predict soil properties with diffuse reflectance spectra. Geoderma, 158(1-2), 46–54.
7. Adamchuk, V. I., Hummel, J. W., Morgan, M. T., & Upadhyaya, S. K. (2004). On-the-go soil sensors for precision agriculture. Computers and Electronics in Agriculture, 44(1), 71–91.
8. กรมพัฒนาที่ดิน. (2560). คู่มือการ วิเคราะห์ตัวอย่างดิน น้ำ ปุ๋ย พืช และ วัสดุปรับปรุงดิน. สำนัก วิทยาศาสตร์เพื่อการพัฒนาที่ดิน กรมพัฒนาที่ดิน กระทรวงเกษตรและสหกรณ์.

### คู่มือปฏิบัติการวิจัยและเทคโนโลยีปัญญาประดิษฐ์ฝังตัว

# บทที่ 6 ประวัติคณะผู้วิจัย

### ผู้ช่วยศาสตราจารย์ ดร.ชีวะ ทัศนา (Co-Principal Investigator)

สาขาวิชาฟิสิกส์ คณะวิทยาศาสตร์และเทคโนโลยี มหาวิทยาลัยราชภัฏรำไพพรรณี คุณวุฒิการศึกษา ปร.ด. (ฟิสิกส์ประยุกต์) สจล. พ.ศ. 2555, วท.ม. (ฟิสิกส์ประยุกต์) สจล. พ.ศ. 2549, วท.บ. (ฟิสิกส์) มน. พ.ศ. 2541
ความ เชี่ยวชาญ ระบบสมองกลฝังตัว ปัญญาประดิษฐ์และการ เรียนรู้ เชิงลึก เกษตร ฟิสิกส์ดิจิทัล และเซนเซอร์อัจฉริยะ
ไปรษณีย์อิเล็กทรอนิกส์ chewa.t@rbru.ac.th

### อาจารย์ธนพัฒน์ ถิระวุฒิ (Principal Investigator)

หลักสูตร คบ.ฟิสิกส์ คณะวิทยาศาสตร์และ เทคโนโลยี มหาวิทยาลัยราชภัฏรำไพ พรรณี
คุณวุฒิการศึกษา วท.ม. (ฟิสิกส์) จุฬาลงกรณ์มหาวิทยาลัย, วท.บ. (ฟิสิกส์) จุฬาลงกรณ์ มหาวิทยาลัย
ความเชี่ยวชาญ วัสดุเชิงประกอบ การพัฒนาต้นแบบวิจัย และระบบตรวจวัดทางฟิสิกส์ ไปรษณีย์อิเล็กทรอนิกส์tanapat.t@rbru.ac.th

### ผู้ช่วยศาสตราจารย์ ดร.นันทพร มูลรังษี (Co-Principal Investigator)

สาขาวิชาเคมี คณะวิทยาศาสตร์และเทคโนโลยี มหาวิทยาลัยราชภัฏรำไพพรรณี คุณวุฒิ การ ศึกษา วท.ด. (เคมี) มหาวิทยาลัย เชียงใหม่, วท.บ. (เคมี) มหาวิทยาลัย เชียงใหม่
ความเชี่ยวชาญ เคมีวิเคราะห์ การสร้างเครื่องมือวิเคราะห์ทางเคมีอย่างง่าย และการ สอบเทียบมาตรฐาน
ไปรษณีย์อิเล็กทรอนิกส์nuntaporn.m@rbru.ac.th
