TsanaPhysics/iSoil-pH-xAI/(commit log)

2026-09-30 feat: complete iSoil pH xAI system (firmware, web dashboard, TinyML ANN, and RBRU academic manual)
    [sample_soil_ph_dataset.csv]
2026-09-30 feat: Add automated multi-session sequential file recording on SD card and SQLite per reset/restart
    [my_ph_wio.ino, serial_bridge.py]
2026-09-30 feat: implement 3-in-1 Combination Probe ATC architecture and real-time AI Confidence Score
2026-09-30 docs: update manual, README, 3-in-1 probe sources, soil pH models, and citations
2026-09-30 fix(ui): polish Wio screen, remove '=' banner prefix, format 25.0 C, fix model overflow, compare AI vs Nernst
    [my_ph_wio.ino]
2026-09-30 feat: add DS18B20 waterproof 1-Wire temperature probe auto-detection on pin A1
2026-10-01 fix(nernst): resolve slope sign inversion bug and calibrate buffer voltage baselines to actual probe readings (pH 4, 7, 10)
    [my_ph_wio.ino]
2026-10-01 fix(temp): eliminate bogus analog ntc fallback returning 49C and ensure pure DS18B20 1-Wire with safe 25C MTC baseline
    [my_ph_wio.ino]
2026-10-01 feat(dashboard): add dedicated prominent Solution Temperature KPI card with live ATC/MTC mode indicator and Nernstian slope
