TsanaPhysics/iSoil-pH-xAI/(notices)

Notices in the files:
README.md:
License: MIT
